slapplebags/heeluxe/Treadmill_Controller_User_Manual.docx

# Treadmill Step Counter Controller

User Manual

StampPLC single treadmill controller
Operator instructions for normal use and basic troubleshooting

Document version 1.2
17 September 2026
For firmware revision 7

# Purpose

This controller counts treadmill steps, stops the treadmill when a selected target is reached, retains the count through a power interruption, and shows operating status on the local display. The controller enables the treadmill's existing run permit; the operator still starts and operates the treadmill using its normal controls.

Operator safety. Use the mushroom E-stop whenever immediate stopping is required. The E-stop's hardwired NC contact opens the treadmill stop or permit circuit independently of the software. Do not bypass the treadmill's original safety key, guards, interlocks, or controls.

# Quick Start

1. Release the mushroom E-stop. Confirm EST OK. If a previous result or fault remains, inspect the machine and record the count, then hold C for three seconds and release to reset.
2. Briefly press A, B, or C to select the desired target shown along the lower portion of the screen.
3. Hold B for at least one second, then release it. The controller changes to ARMED, relay R1 closes, the red indicator turns off, and the green indicator turns on.
4. Start the treadmill with its normal controls. The controller changes to RUNNING after it receives the first optical pulse, and the displayed count increases.
5. When the count reaches the target, the controller opens relay R1, displays TARGET REACHED, activates the red indicator and buzzer, and freezes the completed count.
6. After the treadmill has stopped, hold C for at least three seconds and release it to clear the completed count.

# Controls

Control | Short press | Press and hold
A | Selects target A, normally 10,000 steps | No hold function
B | Selects target B, normally 50,000 steps | Hold 1 second and release to arm, pause, or resume
C | Selects target C, normally 100,000 steps | Hold 3 seconds and release to reset while stopped
Mushroom E-stop | Not applicable | Press to stop; twist or pull as marked to release

Button timing. Actions occur when the button is released. A B hold shorter than one second selects preset B. A C hold between one and three seconds performs no action.

# Indicator Light and Buzzer

Indication | Meaning
Green | The treadmill permit is enabled and the controller is ARMED or RUNNING.
Red | The permit is disabled. This is normal while idle, stopped, complete, or faulted.
Buzzer | Sounds briefly when a stop or fault is registered.

# Display Guide

The center of the display shows the controller state, accumulated step count, selected target, and the three preset values. Status indicators around the perimeter show live inputs and commanded relay states.

## Top indicators

Display | Meaning
OPT OFF | Optical input is inactive according to the configured polarity.
OPT ON | Optical input is active. A debounced inactive-to-active transition counts a step while armed or running.
OPT ERR | The PLC input subsystem is not responding.
EST OK | The E-stop auxiliary input is in the released state.
EST STOP | The E-stop has been pressed or its auxiliary input is active.
EST ERR | RS-485 is disabled and this controller operates as a standalone unit. Wi-Fi remains available.
485 OFF | RS-485 is not enabled in this standalone version.
P485 OK | This unit is the RS-485 primary and at least one other node is communicating. Its Wi-Fi and web interface are active.
S485 OK | This unit is an RS-485 secondary. Its Wi-Fi radio and web server are off.
P485 WAIT | This unit is primary but no peer has responded recently. Wi-Fi remains active.
S485 WAIT | This unit is secondary and is waiting for primary traffic.
ELECT | No usable primary was heard. The unit is participating in automatic primary election.
485 ERR | The RS-485 UART could not be initialized; local treadmill control remains independent.

## Controller states

State | Meaning
IDLE | Stopped and ready for target selection or arming.
ARMED | Permit enabled; waiting for the first optical pulse.
RUNNING | Pulses are being counted.
PAUSED | Permit disabled by the B button or web control; count retained.
TARGET REACHED | Target met; permit disabled and count frozen until reset.
STOPPED | Stopped by the E-stop or another stop command; count retained.
FAULT | A condition prevents operation. See Troubleshooting.

## Bottom relay indicators

Display | Commanded function
R1 | Treadmill run permit
R2 | Green indicator
R3 | Red indicator
R4 | External buzzer

R1 through R4 show the software command sent to each relay. They do not confirm the physical position of the relay contacts or the state of the connected equipment.

The optical badge also flashes for approximately 350 milliseconds after a detected pulse. Automatic screen dimming, wake-only button presses, and pixel shifting are not enabled in this firmware.

# Operating Procedures

## Selecting a target

While stopped, briefly press A, B, or C. The selected target appears after TARGET on the display. Selecting a different target does not clear the accumulated count. Target selection is blocked while armed, running, completing a coast-down count, or holding a completed result.

## Arming and starting

1. Confirm EST OK and verify that no fault is displayed.

2. Select the required target.

3. Hold B for at least one second and release it. Confirm ARMED, green indication, and R1 ON.

4. Start the treadmill using its normal controls. Confirm that the count advances and the state changes to RUNNING.

## Pausing and resuming

Hold B for at least one second and release it while armed or running. The controller opens the permit and changes to PAUSED. Once the treadmill and optical mechanism are settled, hold B again for at least one second and release it to re-arm. Use the treadmill's normal control to restart it if required.

## Using the E-stop

Press the mushroom E-stop for an immediate stop. Its hardwired NC contact opens the treadmill stop or permit circuit, while its separate auxiliary contact tells the StampPLC to display EST STOP and retain the count. Correct the condition that caused the stop, release the E-stop, and verify EST OK before resetting or re-arming.

## Completing and resetting a run

At the target, the controller disables the permit and freezes the count until reset. Record the result before clearing it. After all motion has stopped, release the E-stop, hold C for three full seconds, and release. A successful reset shows Reset OK - stopped, clears the count and fault, silences the external buzzer, and returns to IDLE. The target stays unchanged and the treadmill remains stopped. Hold B separately to arm another run.

A reset is rejected if the controller is armed or running, the E-stop is active or still settling, the input subsystem cannot be read, or the FRAM cannot save and verify the reset. Recent optical pulses no longer block reset. Arming and local preset selection still require three seconds without an optical transition.

Reset retries communication with the inputs and, when unavailable, the FRAM. It clears a recoverable fault only after those checks and the saved reset succeed. If saving fails, the displayed count is restored and the controller stays faulted. Reset messages appear on the screen for eight seconds; the web dashboard retains the latest reset message.

After a pause or non-completion stop, pulses during coast-down may still increase the count. At TARGET REACHED the completed count stays frozen. Reset clears any coast-down counting.

## After a power interruption

The FRAM restores the saved count and target. The controller does not automatically restore the treadmill permit. If power was lost while armed or running, the controller enters FAULT to require inspection before another run. A pulse occurring during the instant of power loss may not be retained.

# Web Interface

The display alternates between the controller address and the local button reminder when no error or reset message takes priority. Only the standalone unit or elected primary provides Wi-Fi. Enter http:// followed by the primary's displayed address in a browser. Use the credentials supplied by the installer; unchanged defaults are listed below.

Setting | Default
Controller Wi-Fi name | flux- followed by the controller identifier
Controller Wi-Fi password | fluxcapacitor
Direct connection address | http://192.168.4.1
Web username | admin
Web password | change-this-password

## Connecting to an existing network

1. Stop the run and wait for all motion to stop. Saving or clearing Wi-Fi settings restarts the controller; the settings page does not block this during a run.

2. For first setup, connect your phone or computer to the controller's flux- network. Open http://192.168.4.1 and sign in.

3. Open Wi-Fi settings. Enter the network name and password, then save. Use a compatible 2.4 GHz personal Wi-Fi network. A blank password is for an open network; enterprise username-based login is not supported by this sketch.

4. After the restart, connect your phone or computer to the same network and open the controller's new address shown on its display.

The controller remembers these settings across power cycles. If it cannot connect after about 15 seconds, it starts its fallback flux- network and continues retrying the saved network about every 30 seconds. Reconnect directly to http://192.168.4.1 to correct the credentials. Forgetting the saved network restarts the controller in access-point mode. Resetting the count does not erase Wi-Fi settings.

Use the web interface on a trusted network. The installer changes the default access-point and web passwords in the sketch; the Wi-Fi settings form changes only the network the controller joins.

## Web controls

Web control | Function
Pause and stop | Opens the permit and retains the count.
Stop | Stops the current operation and retains the count.
Acknowledge | Silences the external buzzer only. Does not clear a fault or reset the count.
Reset count | Clears the count when all reset conditions are satisfied.
Set target | Sets 1 to 1,000,000,000 steps while stopped and without a completed result. Does not change A/B/C presets or clear the count.

The web interface does not replace the mushroom E-stop or the treadmill's normal controls. A secondary intentionally has no Wi-Fi. Loss of Wi-Fi does not stop local pulse counting or disable the hardwired E-stop circuit.

Arming is local only: use a one-second B hold and release. The web interface has no Arm control. After a web reset, check the displayed count, state, and latest reset message to confirm the result.

# RS 485 Network Operation

Every networked controller runs the same firmware and keeps controlling its own treadmill locally. Each unit must have a unique address from 1 through 8. Address 1 is the preferred primary, but any node can become primary after a failure.

## Primary and secondary behavior

- The elected primary polls the other nodes, collects their status and provides the Wi-Fi web interface.
- Secondary units switch their Wi-Fi radios completely off. This prevents multiple controller access points from appearing during normal operation.
- If primary traffic disappears, election normally completes in approximately 7 to 9 seconds. The replacement primary then starts Wi-Fi using its own saved network settings and its own flux- access-point name.
- When a lower-address node returns, it becomes primary and the higher-address unit returns to secondary operation and shuts Wi-Fi off.

A broken or disconnected RS-485 cable can divide the system into separate groups. Each isolated group may elect its own primary and enable its own Wi-Fi. When the cable is restored, the groups settle on the lowest available node address as the single primary.

## Using the network dashboard

Open the web interface of the current primary. The dashboard provides a tab for each discovered node. A node tab shows its count, target, state, inputs, relay commands and communication age. Remote stop, pause, acknowledge, reset and target commands are sent over RS-485; arming remains a local button action at the treadmill.

Do not act on a node marked STALE or OFFLINE. Confirm the command result and the physical state at the affected treadmill. Network loss does not bypass the hardwired E-stop or stop local counting.

## Configuring or servicing a secondary

1. Disconnect that unit from the RS-485 bus, or turn off the current primary.

2. Wait approximately 7 to 9 seconds for the unit to elect itself primary and enable Wi-Fi. If it cannot join its saved network, its fallback flux- access point appears after approximately 15 seconds.

3. Connect to the address shown on its display, make the required change, then restore the RS-485 connection.

Firmware revision 7 does not provide browser-based firmware upload. Install new firmware over USB on every node. Do not mix revision 6 and revision 7 nodes on the same RS-485 network.

# Troubleshooting

Reset message | Action
Reset OK - stopped | Reset succeeded. Count is zero; arm separately when ready.
Reset: stop run first | Pause or stop before resetting.
Reset: release E-stop | Release the mushroom, confirm EST OK, then retry.
Reset: input IO fault | Input communication failed. Have the installer check the controller if a retry fails.
Reset: FRAM bus fault | FRAM bus could not initialize. Check with the installer.
Reset: FRAM missing | FRAM did not respond. Have its connection and power checked.
Reset: FRAM save failed | Reset could not be verified. Count remains displayed; repair storage before another run.

## Other symptoms

Symptom | Check
BENCH LOCK | The commissioning lock remains enabled in firmware. The installer must verify the wiring and load the production configuration.
C does not reset | Stop or pause, release the E-stop, hold C for 3 seconds and release. Read the reset message; a C hold between 1 and 3 seconds does nothing.
Count does not advance | Confirm RUNNING or ARMED, observe OPT OFF and OPT ON as the interrupter changes, and check sensor alignment and wiring.
Count advances twice | Check for a loose or vibrating flag, marginal alignment, or multiple optical transitions per mechanical step.
Will not arm | Check EST OK, FRAM status, input status, target greater than count, and that no optical transition occurred during the last 3 seconds.
FAULT after startup | Power may have failed during a run, or the FRAM/input subsystem failed. Inspect the treadmill and count before resetting.
Pulse timeout | No first pulse arrived within 60 seconds of arming, or no pulse arrived for 15 seconds while running. Inspect the sensor and treadmill, then reset before re-arming.
Red light while idle | Normal. Red means the treadmill permit is disabled.
R1 ON but treadmill will not run | Check the E-stop, original treadmill controls, safety key, and permit-loop wiring. R1 only enables the permit.
No controller Wi-Fi | Check the displays. S485 means the unit is a secondary and Wi-Fi is intentionally off. Connect to the unit showing P485, or isolate the required unit and wait for it to become primary.
RS-485 icon is not OK | Confirm every node has a unique address, firmware revision 7, A-to-A, B-to-B and signal ground continuity. Terminate only the two physical ends of the bus.
Primary changed | This is expected after communication loss or a lower-address node returns. Reconnect to the new primary's saved network or flux- access point.
Node tab is stale or offline | Do not repeat control commands blindly. Inspect bus wiring and the affected unit, then confirm its local display and treadmill state.

# Care and Inspection

- Before use, check the enclosure, cable security, sensor mounting, and target flag.
- Test the E-stop regularly and confirm that it stops the treadmill even if the StampPLC is rebooting or unresponsive.
- Keep the optical slot clean. Stop using the counter if counts become erratic; have sensor alignment and mounting checked.
- Have the installer perform electrical repairs with power isolated.

Treadmill Step Counter Controller User Manual |
